flaviofersu-pixel/spotify-gadget/docs/case-v7-top-view.png

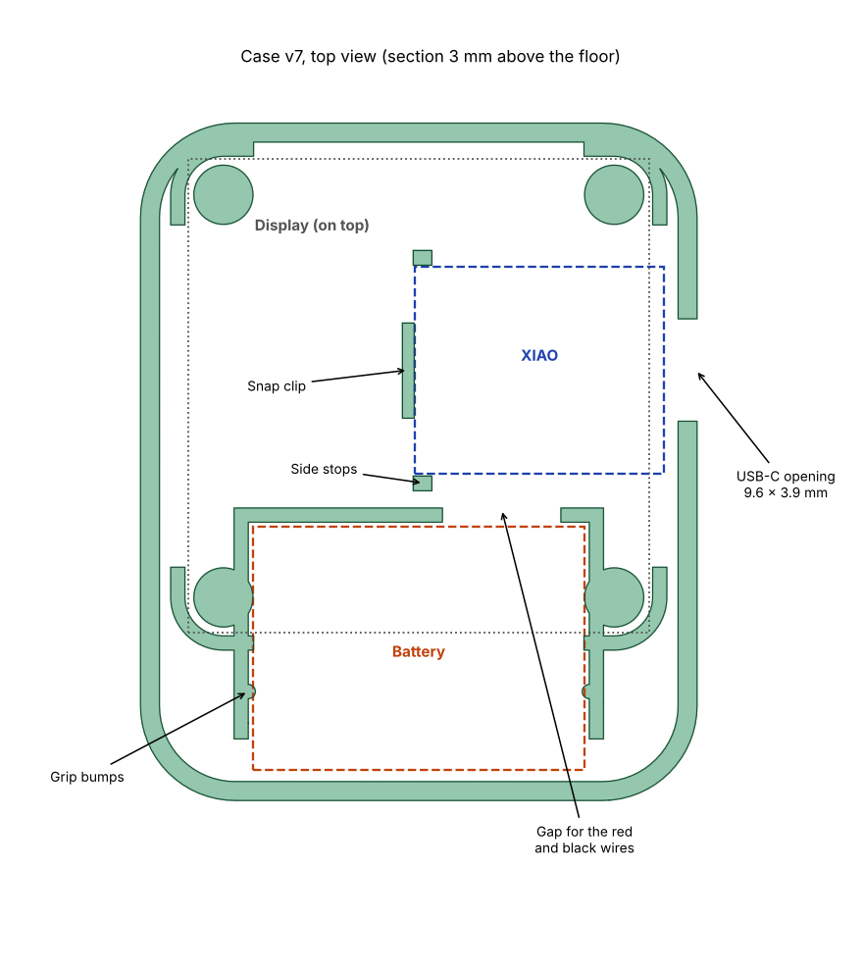
docs/case-v7-top-view.png
