flaviofersu-pixel/spotify-gadget/hardware/pcb/v0.1/mini-remote-v0.1-preview.png

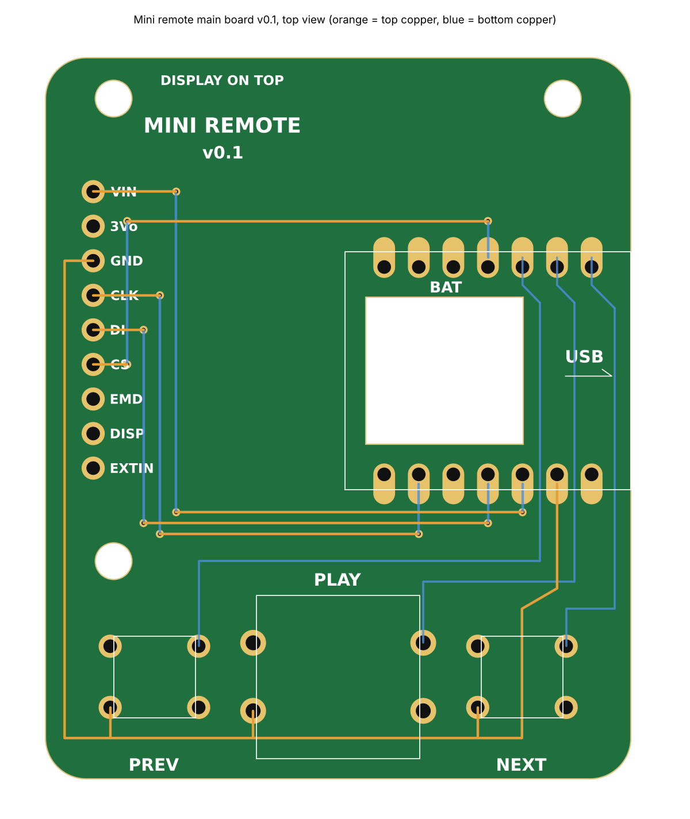
hardware/pcb/v0.1/mini-remote-v0.1-preview.png
