flaviofersu-pixel/spotify-gadget/media/photos/case-v1-dimensions.png

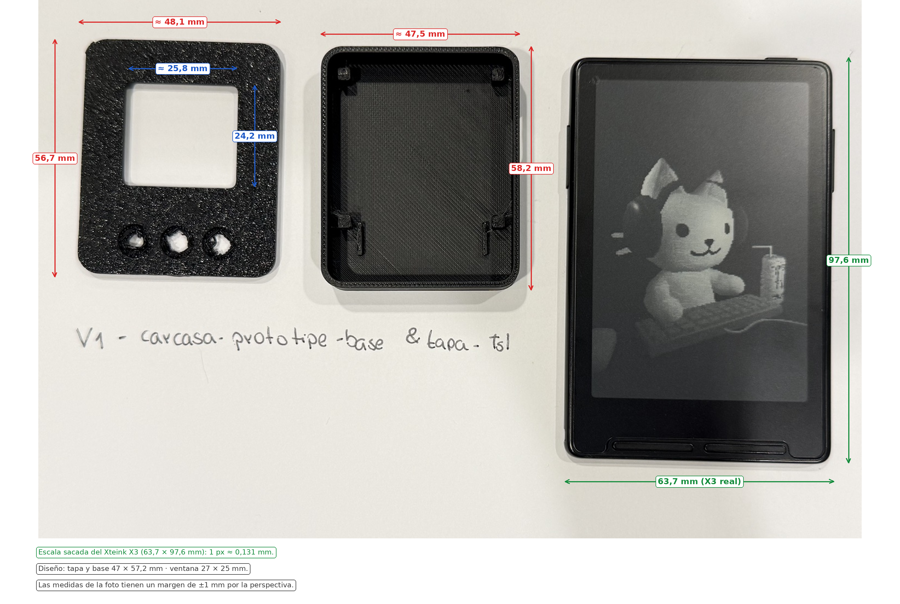
media/photos/case-v1-dimensions.png
