flaviofersu-pixel/spotify-gadget/media/renders/remote-bottom.png

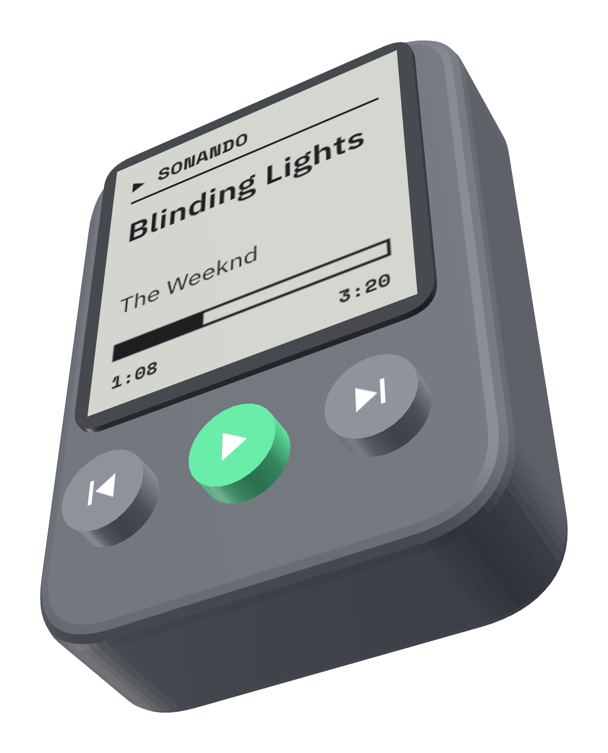
media/renders/remote-bottom.png
