flaviofersu-pixel/spotify-gadget/media/renders/remote-front.png

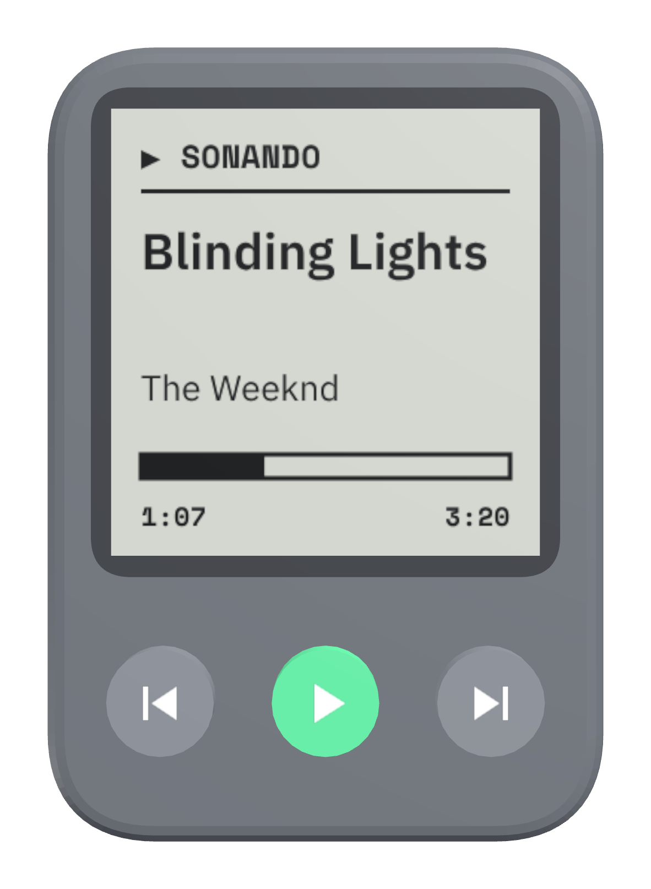
media/renders/remote-front.png
