flaviofersu-pixel/spotify-gadget/media/renders/remote-side.png

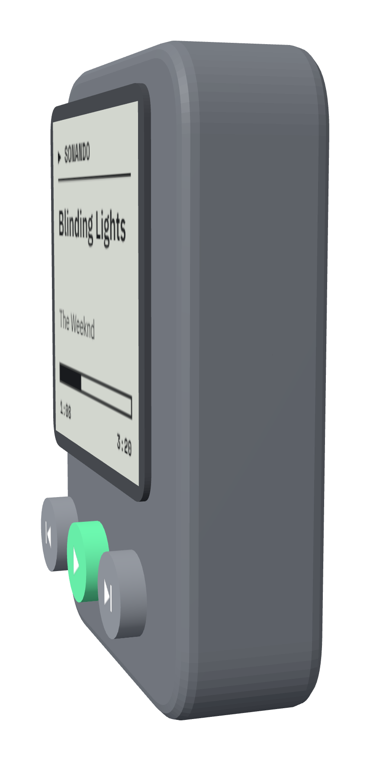
media/renders/remote-side.png
