flaviofersu-pixel/spotify-gadget/media/renders/robot-keychain.png

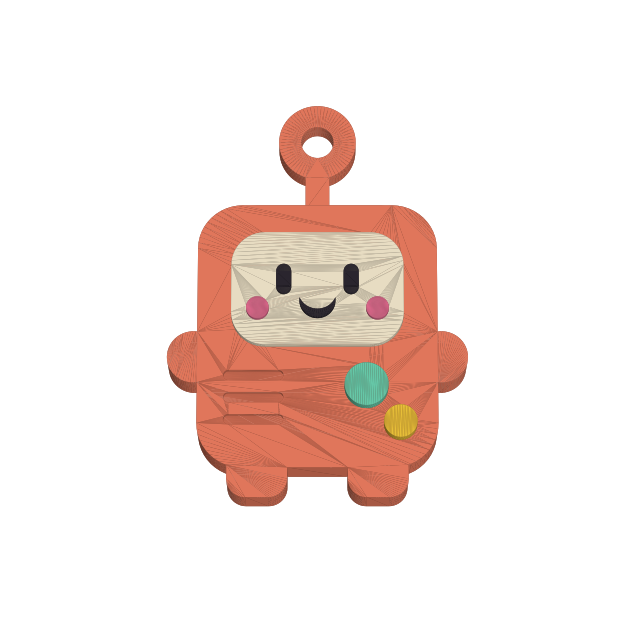
media/renders/robot-keychain.png
