flaviofersu-pixel/spotify-gadget/keychain/robot-keychain/robot-keychain-complete.stl

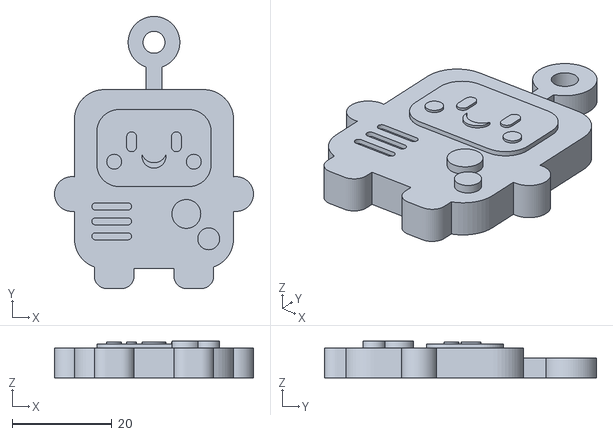
[picture p12: CAD file, 2026-11-04]
keychain/robot-keychain/robot-keychain-complete.stl
40.0 x 54.7 x 7.40
