flaviofersu-pixel/spotify-gadget/hardware/case/v0-size-test/size-test-block-26x38x9.stl

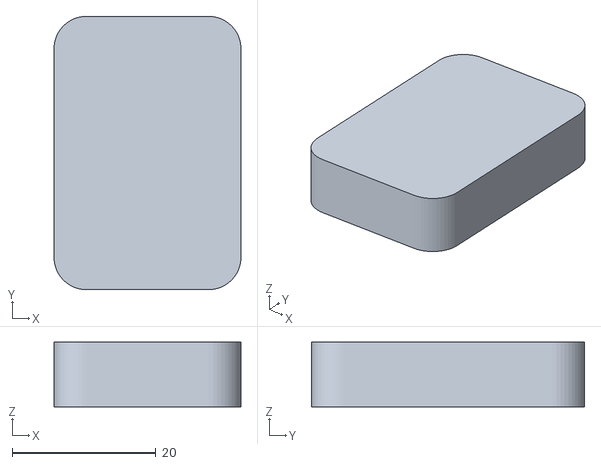
[picture p13: CAD file, 2026-11-04]
hardware/case/v0-size-test/size-test-block-26x38x9.stl
26.0 x 38.0 x 9.00
