flaviofersu-pixel/spotify-gadget/hardware/case/v7/prototype-case-v7-plate.3mf

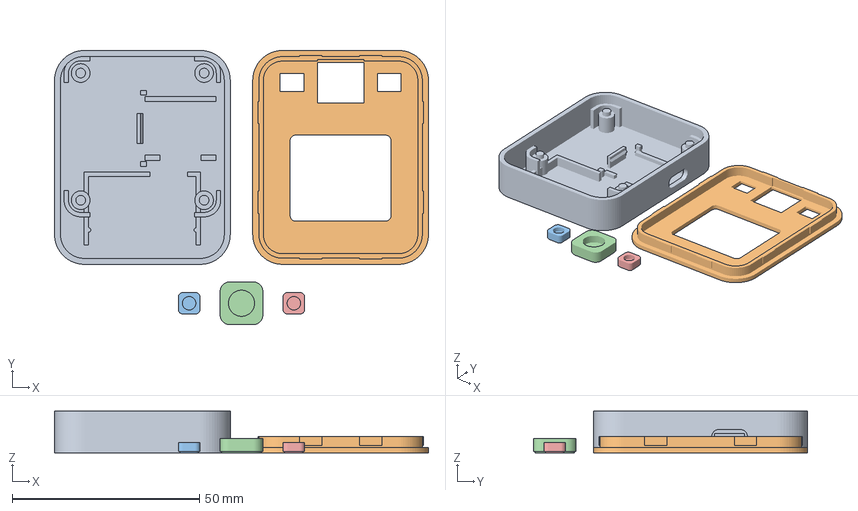
[picture p14: CAD file, 2026-11-04]
hardware/case/v7/prototype-case-v7-plate.3mf
100.0 x 73.3 x 11.1 mm
base
lid
cap-previous
cap-play-pause
cap-next
