flaviofersu-pixel/spotify-gadget/keychain/robot-keychain/part-body.stl

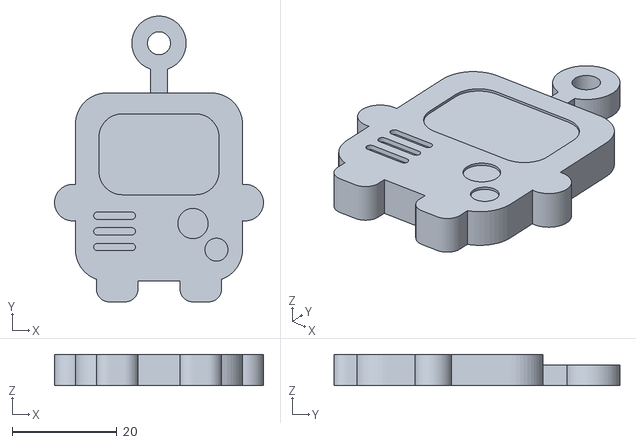
[picture p15: CAD file, 2026-11-04]
keychain/robot-keychain/part-body.stl
40.0 x 54.7 x 6.00
