flaviofersu-pixel/spotify-gadget/keychain/slim-keychain/keychain-print-plate.3mf

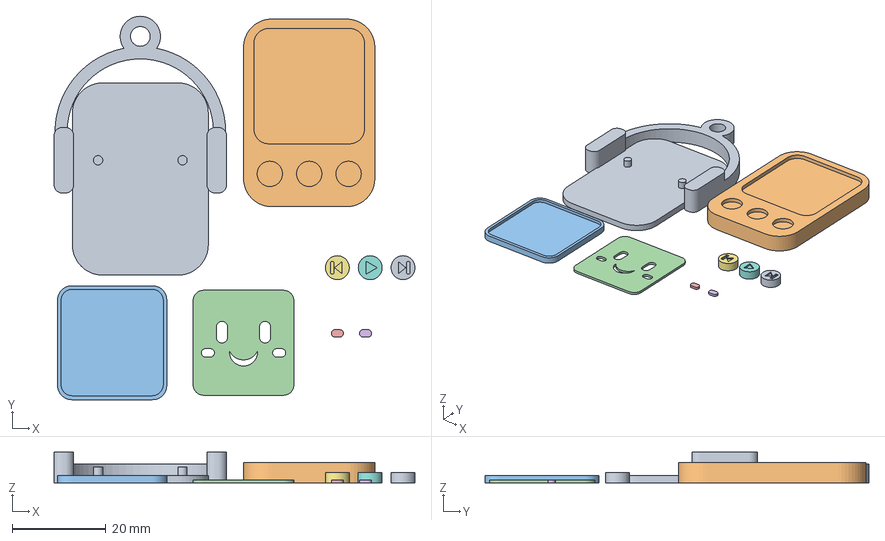
[picture p16: CAD file, 2026-11-04]
keychain/slim-keychain/keychain-print-plate.3mf
76.9 x 81.7 x 6.60 mm
1-placa-auriculares
2-cuerpo
3-marco-pantalla
4-pantalla
5-mejilla-izq
5-mejilla-der
6-boton-anterior
6-boton-play
6-boton-siguiente
