flaviofersu-pixel/spotify-gadget/keychain/robot-keychain/part-screen.stl

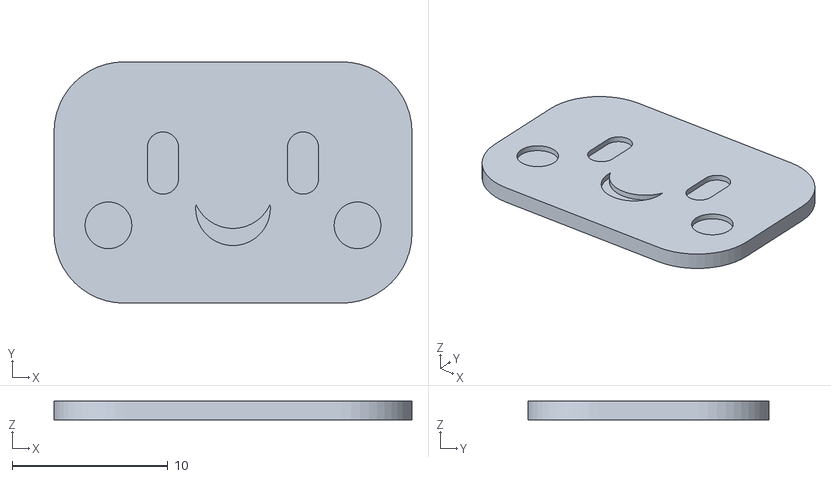
[picture p17: CAD file, 2026-11-04]
keychain/robot-keychain/part-screen.stl
23.0 x 15.5 x 1.20
