flaviofersu-pixel/spotify-gadget/keychain/robot-keychain/part-button-yellow.stl

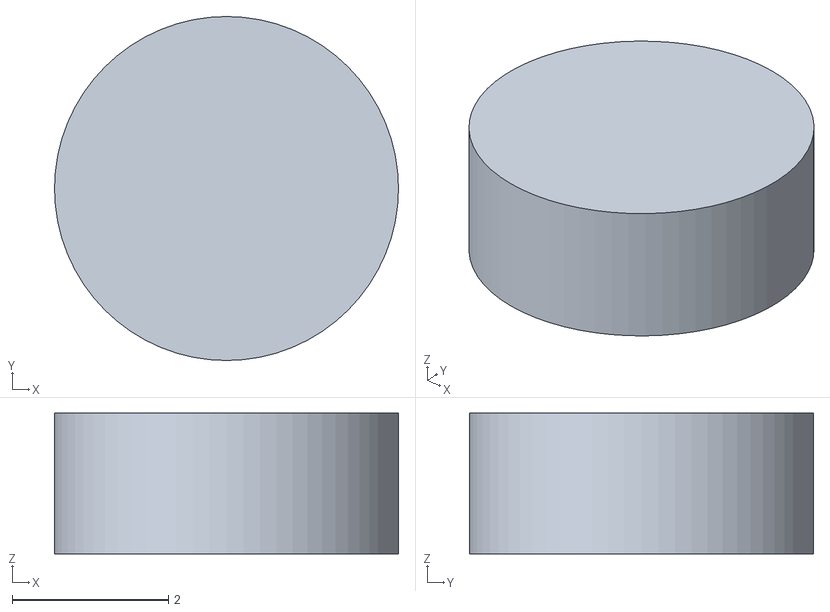
[picture p18: CAD file, 2026-11-04]
keychain/robot-keychain/part-button-yellow.stl
4.40 x 4.40 x 1.80
