flaviofersu-pixel/spotify-gadget/keychain/robot-keychain/part-face.stl

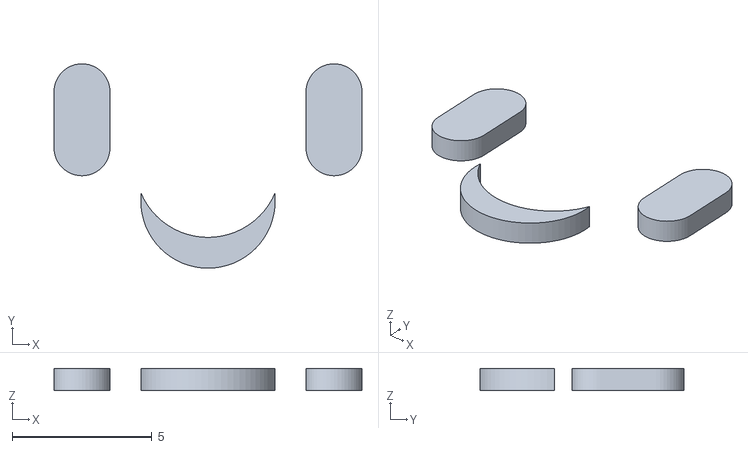
[picture p19: CAD file, 2026-11-04]
keychain/robot-keychain/part-face.stl
11.0 x 7.30 x 0.8
