flaviofersu-pixel/spotify-gadget/keychain/robot-keychain/part-cheeks.stl

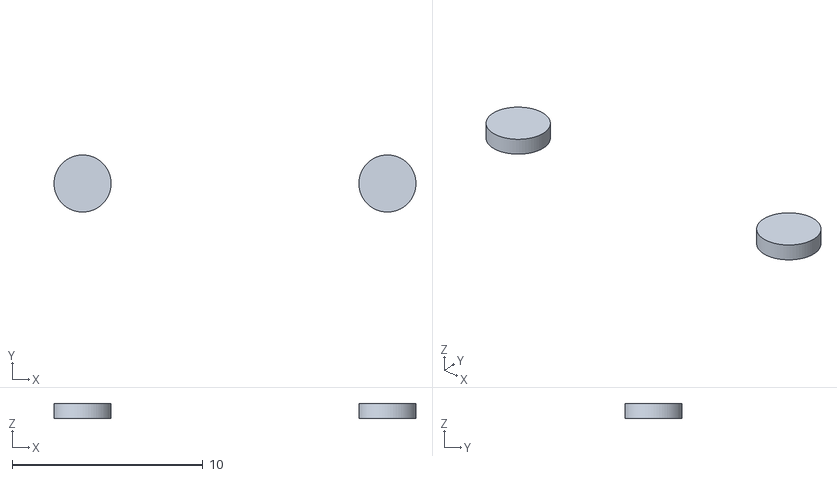
[picture p20: CAD file, 2026-11-04]
keychain/robot-keychain/part-cheeks.stl
19.0 x 3.00 x 0.8
