flaviofersu-pixel/spotify-gadget/keychain/robot-keychain/part-button-mint.stl

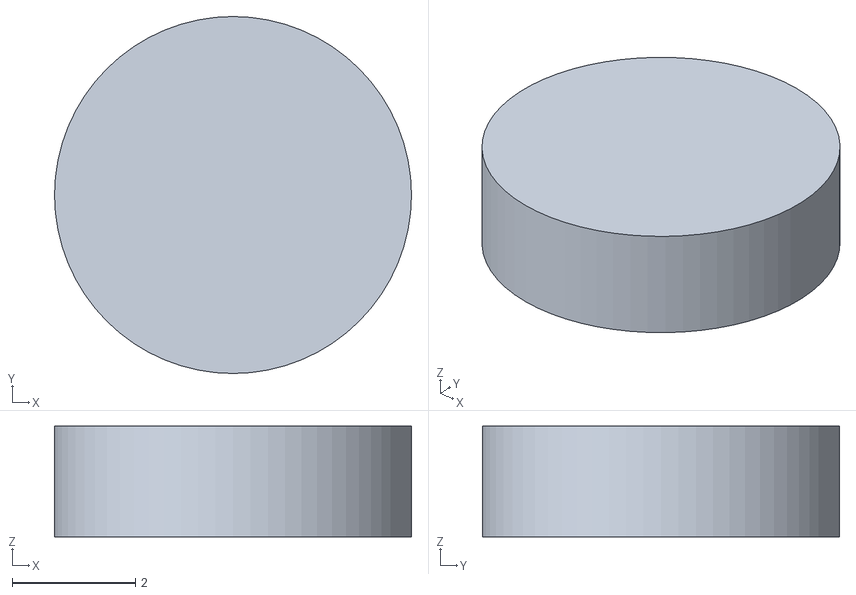
[picture p21: CAD file, 2026-11-04]
keychain/robot-keychain/part-button-mint.stl
5.80 x 5.80 x 1.80
