flaviofersu-pixel/spotify-gadget/hardware/case/v1/prototype-case-v1-lid.stl

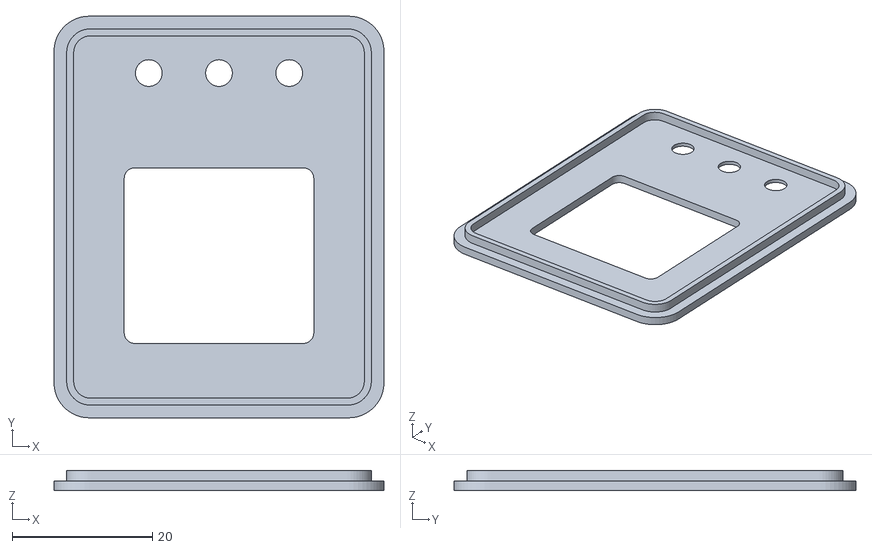
[picture p22: CAD file, 2026-11-04, an earlier design]
hardware/case/v1/prototype-case-v1-lid.stl
47.0 x 57.2 x 2.90
