flaviofersu-pixel/spotify-gadget/hardware/case/v2/prototype-case-v2-base-and-lid.3mf

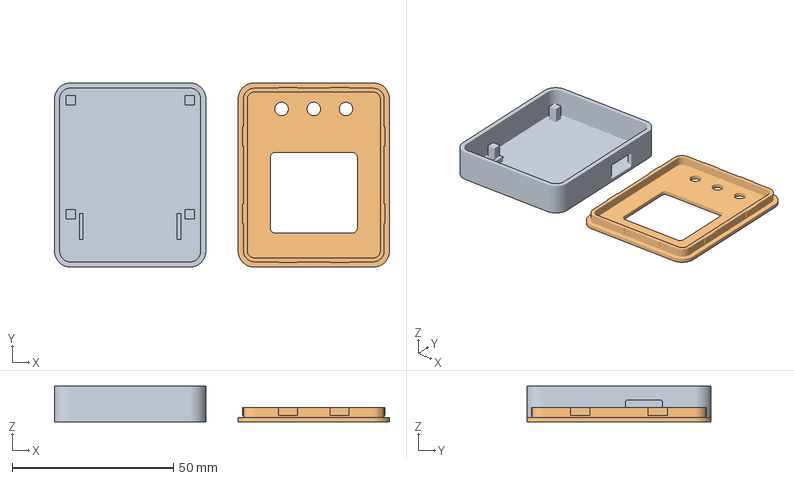
[picture p23: CAD file, 2026-11-04, an earlier design]
hardware/case/v2/prototype-case-v2-base-and-lid.3mf
104.0 x 57.2 x 11.1 mm
base
lid
