flaviofersu-pixel/spotify-gadget/hardware/case/v5/prototype-case-v5-base-and-lid.3mf

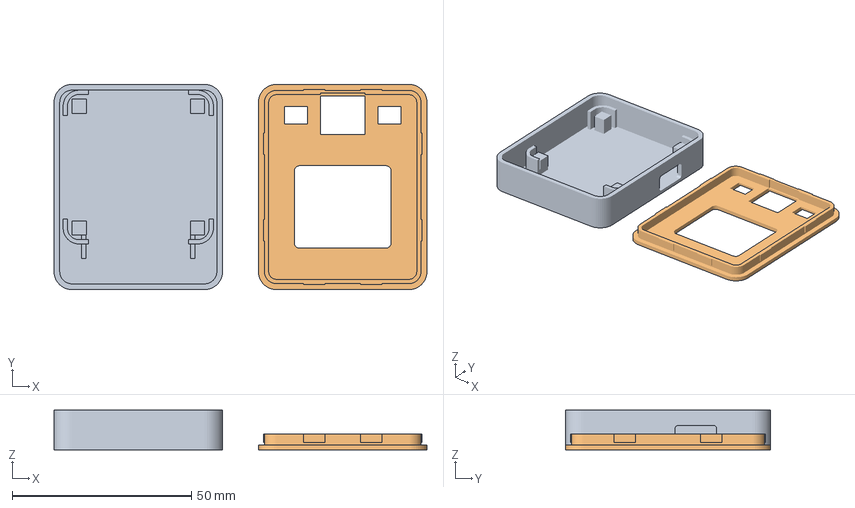
[picture p24: CAD file, 2026-11-04, an earlier design]
hardware/case/v5/prototype-case-v5-base-and-lid.3mf
104.0 x 57.2 x 11.1 mm
base
lid
