flaviofersu-pixel/spotify-gadget/(list of files, cad)

Other CAD files:
keychain/robot-keychain/robot-keychain-multicolor.3mf
hardware/case/v3/prototype-case-v3-base-and-lid.3mf
hardware/case/v4/prototype-case-v4-base-and-lid.3mf
hardware/case/v6/prototype-case-v6-base-and-lid.3mf
hardware/case/v1/prototype-case-v1-base-and-lid.3mf
hardware/case/v1/prototype-case-v1-base-and-lid.stl
hardware/case/v1/prototype-case-v1-base.stl
hardware/case/v2/prototype-case-v2-base-and-lid.stl
hardware/case/v3/prototype-case-v3-base-and-lid.stl
hardware/case/v3/prototype-case-v3-lid.stl
hardware/case/v4/prototype-case-v4-base-and-lid.stl
hardware/case/v4/prototype-case-v4b-lid-no-ledges.stl
hardware/case/v5/prototype-case-v5-base-and-lid.stl
hardware/case/v6/prototype-case-v6-base-and-lid.stl
hardware/case/v7/prototype-case-v7-plate.stl
keychain/slim-keychain/keychain-print-plate.stl
