flaviofersu-pixel/spotify-gadget/media/renders/keychain-assembled.png

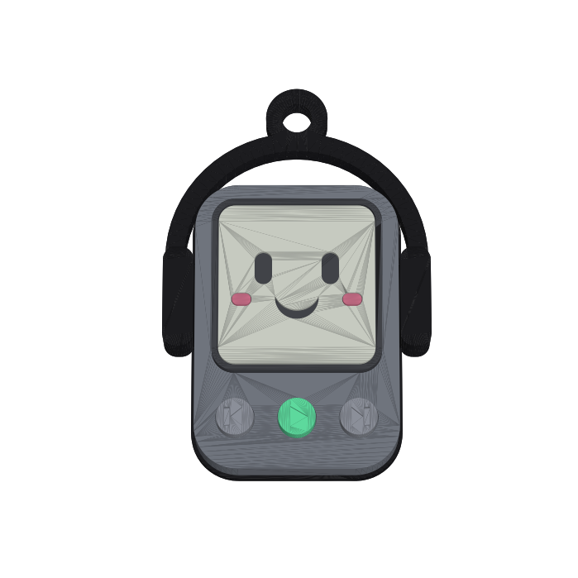
media/renders/keychain-assembled.png
