flaviofersu-pixel/spotify-gadget/media/renders/keychain-print-plate.png

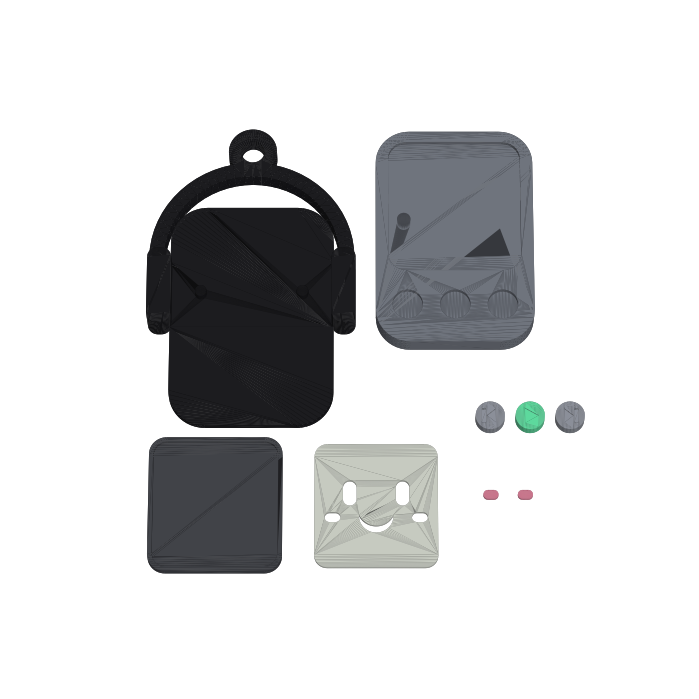
media/renders/keychain-print-plate.png
