flaviofersu-pixel/spotify-gadget/hardware/pcb/v0.1/mini-remote-v0.1-template-1to1.pdf

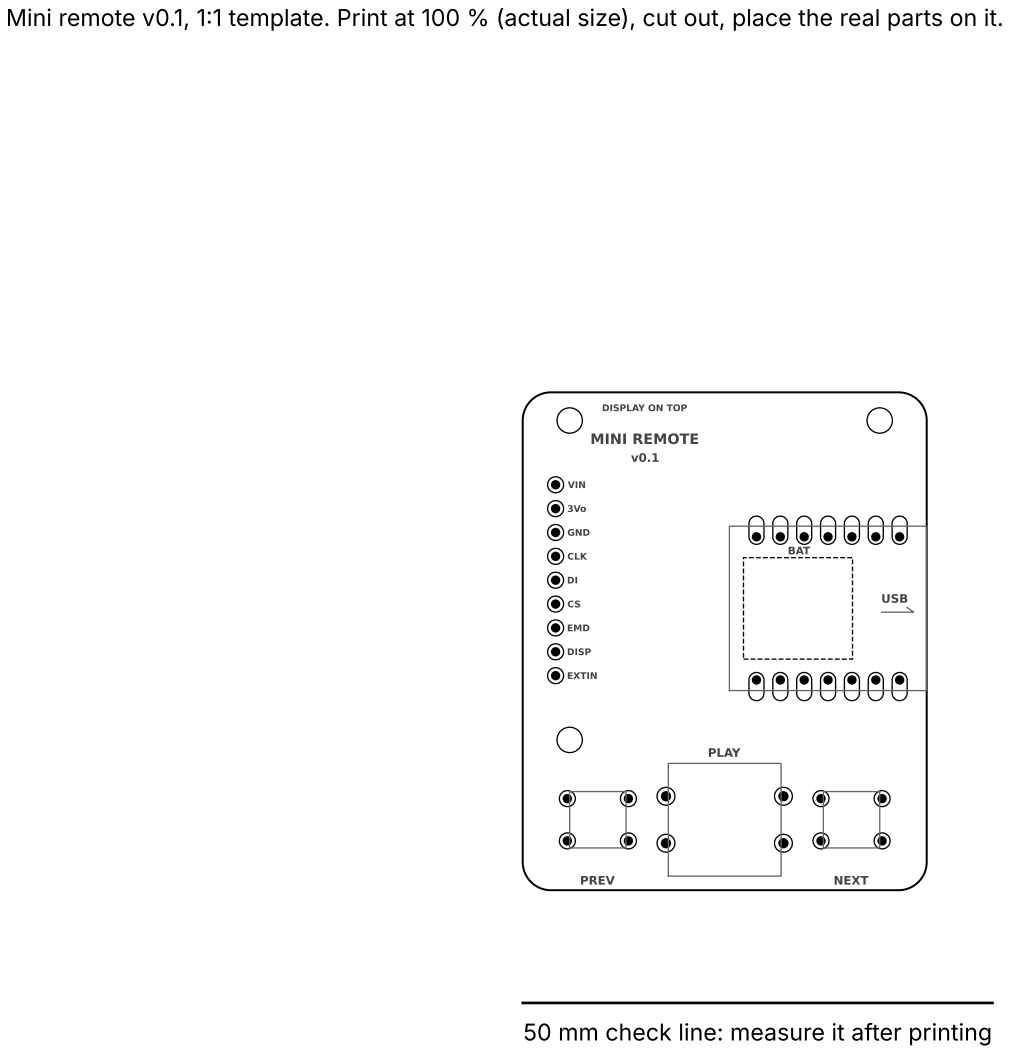
[picture p27: page 1]

Mini remote v0.1, 1:1 template. Print at 100 % (actual size), cut out, place the real parts on it.

50 mm check line: measure it after printing
