flaviofersu-pixel/spotify-gadget/(commit log)

2026-10-30 feat: add the prototype files & the printed v1 prototype case
    [v1-prototype-case.3mf, v2-prototype-case-base-and-lid.3mf, v2-prototype-case-base-and-lid.stl]
2026-11-01 Add Mini Mando: A Bluetooth remote for Spotify on iPhone
    [prototype-case-v6-base-and-lid.3mf]
2026-11-04 Reorganize repo to document the full build process
    Add README with the project story, iteration log (case v0-v7, PCB v0.1),
    bill of materials and wiring. Group files into firmware/, hardware/,
    simulation/, keychain/ and media/, rename files to English and translate
    the simulation code comments.
    Claude-Session: https://claude.ai/code/session_01M52gGoF1daDhyXAcq5tdQs
    [keychain-print-plate.3mf, keychain-print-plate.stl, part-body.stl, part-button-mint.stl, part-button-yellow.stl, part-cheeks.stl, part-face.stl, part-screen.stl]
2026-11-04 Show only the standalone remote model
    Remove the renders and models of the remote mounted on the phone and
    use the standalone remote render and 3D model instead, with a small
    model-viewer page.
    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
    [phone-ereader-remote-assembly.3mf, phone-ereader-remote-assembly.stl]
2026-11-04 feat: add USB power detection, and improve battery status display
